epsilonrt/piphons/extras/hardware/gerber/piphons-shield - CADCAM Mechanical 1.TXT

G04 PROTEUS RS274X GERBER FILE*
%FSLAX24Y24*%
%MOIN*%
%ADD36C,0.0080*%
G54D36*
X-16732Y-11007D02*
X+16732Y-11007D01*
X+16732Y+11039D01*
X-16732Y+11039D01*
X-16732Y-11007D01*
M00*
