epsilonrt/piphons/examples/piphons-demo/README.md

# [libpiphons](https://github.com/epsilonrt/piphons) Full PiPhons example

This example shows how to manage a voice server.  
The program waits for a call, counts the number of rings and picks up
the phone after 3 rings.  
After a welcome message, the program waits for the other party to press
keys and diffuse a different message for each one.  
If the other party presses 2 # keys successively, the server says a
goodbye message and hangs up the phone.  

To build this program, you must type the command:

    $ g++ -o piphons-demo main.cpp $(pkg-config --cflags --libs libpiphons)
    
You can then execute the program :

    $ sudo ./piphons-demo

`sudo` is necessary for an access to the memory mapping of the GPIO. 
You can enable the **setuid** bit to avoid `sudo` in the future :

    $ sudo chmod u+s piphons-demo
    $ ./piphons-demo

With [Codelite](https://codelite.org/) it's easier and funny, right ? 

Debugging with Codelite

The `libpiphons-dev` package installs a project template in Codelite...
