epsilonrt/piphons/extras/hardware/piphons-shield-bom.ods

Category | Quantity | Reference | Value | Order Code | Package
Resistors | 1 | R1 | 10k |  | 2512
Resistors | 3 | R2,R6,R9 | 1k |  | 0805
Resistors | 1 | R3 | 22R |  | 1206
Resistors | 3 | R4,R5,R8 | 33k |  | 0805
Resistors | 6 | R7,R11,R12,R14,R15,R17 | 100k |  | 0805
Resistors | 1 | R10 | 300R |  | 0805
Resistors | 1 | R13 | 43k |  | 0805
Resistors | 1 | R16 | 300k |  | 0805
Resistors | 1 | R18 | 27k |  | 0805
Resistors | 1 | R19 | 1k2 |  | 0805
Resistors | 1 | R20 | 10k |  | 0805
Capacitors | 2 | C1,C9 | 100pF |  | 0805
Capacitors | 1 | C2 | 470n |  | 1812
Capacitors | 1 | C3 | 1u |  | 0805
Capacitors | 1 | C4 | 1nF |  | 0805
Capacitors | 1 | C5 | 10uF |  | 1206
Capacitors | 1 | C6 | 4.7uF |  | 0805
Capacitors | 8 | C7,C10-C13,C16,C18,C22 | 100nF |  | 0805
Capacitors | 1 | C8 | 22uF |  | 0805
Capacitors | 2 | C14,C15 | 22p |  | 0805
Capacitors | 3 | C17,C20,C23 | 1uF |  | 0805
Capacitors | 1 | C19 | 2.2uF |  | 0805
Capacitors | 1 | C21 | 33nF |  | 0805
Integrated Circuits | 1 | U1 | 4N35 |  | DIL06
Integrated Circuits | 1 | U2 | LH1540AT |  | DIL06
Integrated Circuits | 1 | U3 | LMV358M |  | SOIC127P600X175-8
Integrated Circuits | 1 | U4 | HT9170D |  | SOP18W
Integrated Circuits | 1 | U5 | LM567 |  | SO8
Transistors | 1 | Q1 | FZT600 |  | SOT223-3
Transistors | 1 | Q2 | MMBT3904 |  | SOT23-Q
Diodes | 1 | D1 | SMBJ160CA |  | DO214-AA
Diodes | 2 | D2,D3 | MMSZ5230BT1G |  | SOD123
Diodes | 1 | D4 | LED-RED |  | LEDC2012X120
Diodes | 2 | D5,D6 | MMSZ15T1G |  | SOD123
Diodes | 1 | D7 | SMBJ15CA |  | DO214-AA
Diodes | 1 | D8 | LED-GREEN |  | LEDC2012X120
Diodes | 1 | D9 | MB2S |  | SOIC4
Miscellaneous | 1 | FU1 | 500mA |  | 1812
Miscellaneous | 1 | J1 | RJ11-6P4C |  | RJ11-6P4C
Miscellaneous | 1 | J2 | CONN3-JACK |  | CONN-3-MX387GL
Miscellaneous | 1 | J3 | CONN-5 |  | CONN-5-HE14
Miscellaneous | 1 | P1 | CONN-2X13 |  | CONN-2X13-HE14
Miscellaneous | 14 | PT1-PT14 | TEST-POINT |  | TP-TAB37800868
Miscellaneous | 1 | TR1 | SM-LP-5001 |  | TR-SM-LP-5001
Miscellaneous | 1 | X1 | 3MHz579545 |  | XTAL18
