epsilonrt/piphons/extras/hardware/piphons-shield-pcb.pdf

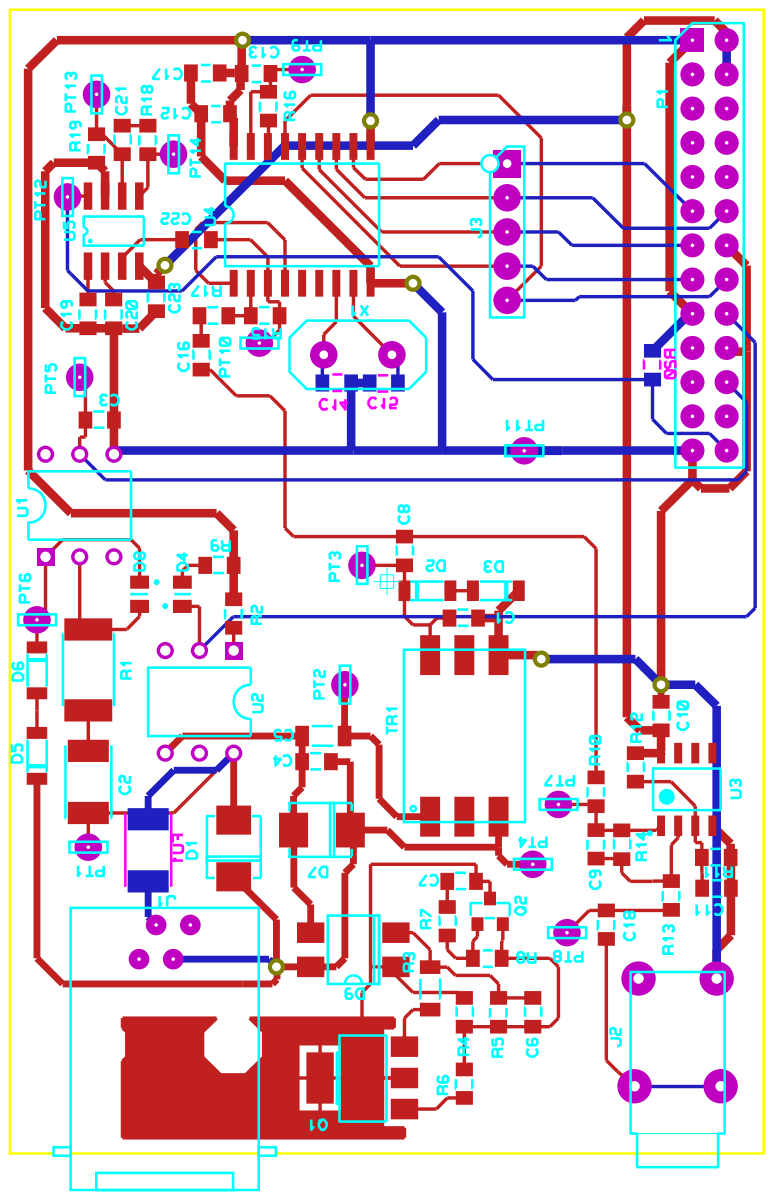
[picture p3: page 1]
