epsilonrt/piphons/extras/hardware/piphons-shield-sch.pdf

D4

PT2

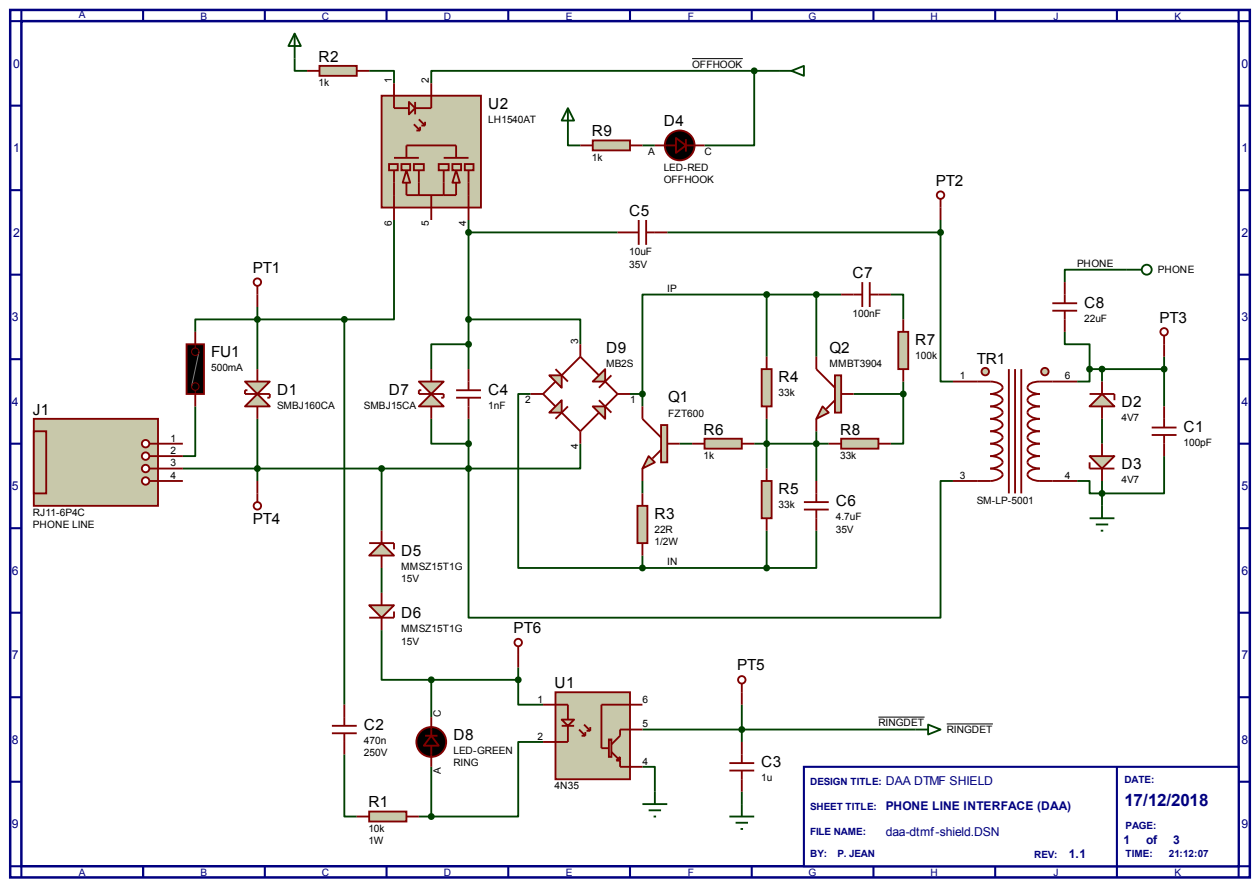
[picture p4: page 1]

DESIGN TITLE: DAA DTMF SHIELD

PHONE LINE INTERFACE (DAA)
daa-dtmf -shield.DSN

R10

R12

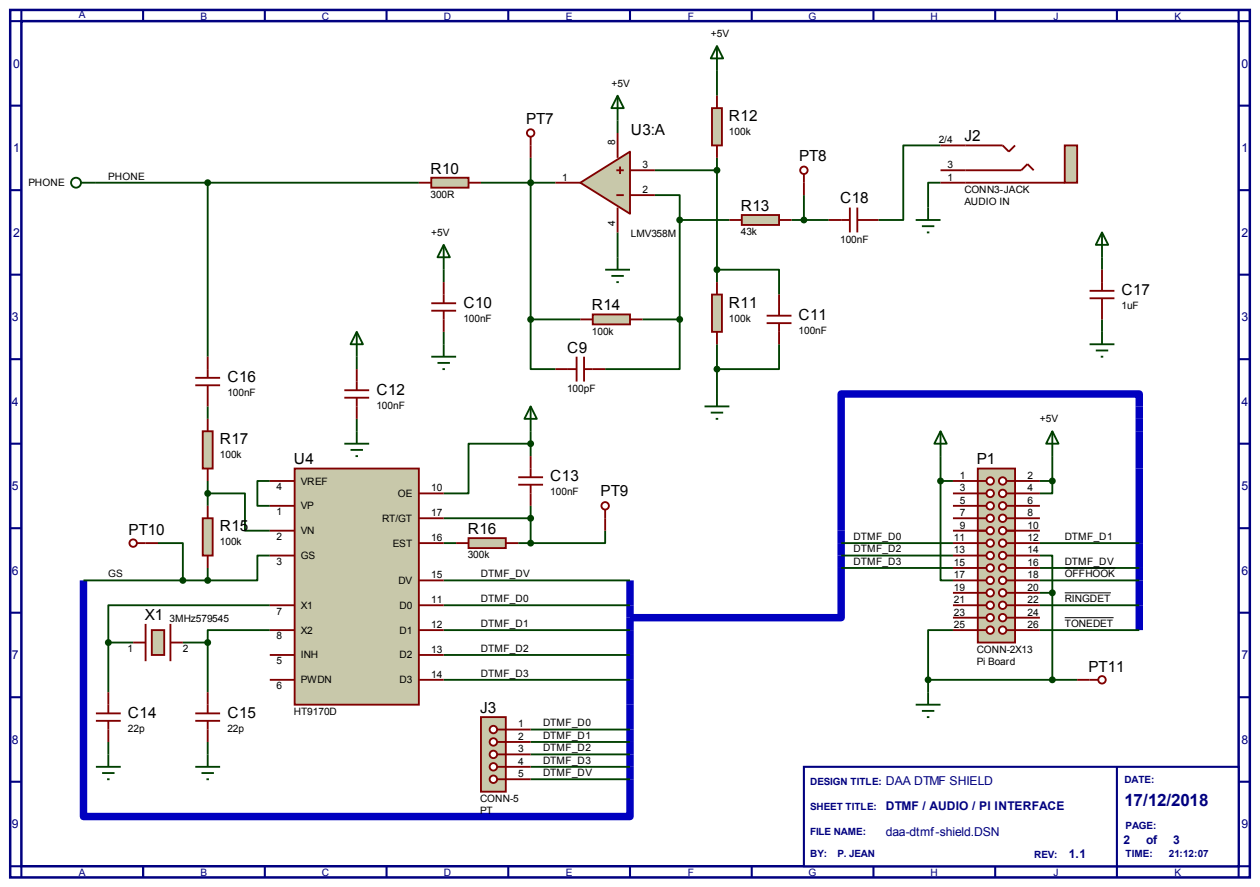
[picture p5: page 2]

DESIGN TITLE: DAA DTMF SHIELD

DTMF / AUDIO / PI INTERFACE
daa-dtmf -shield.DSN

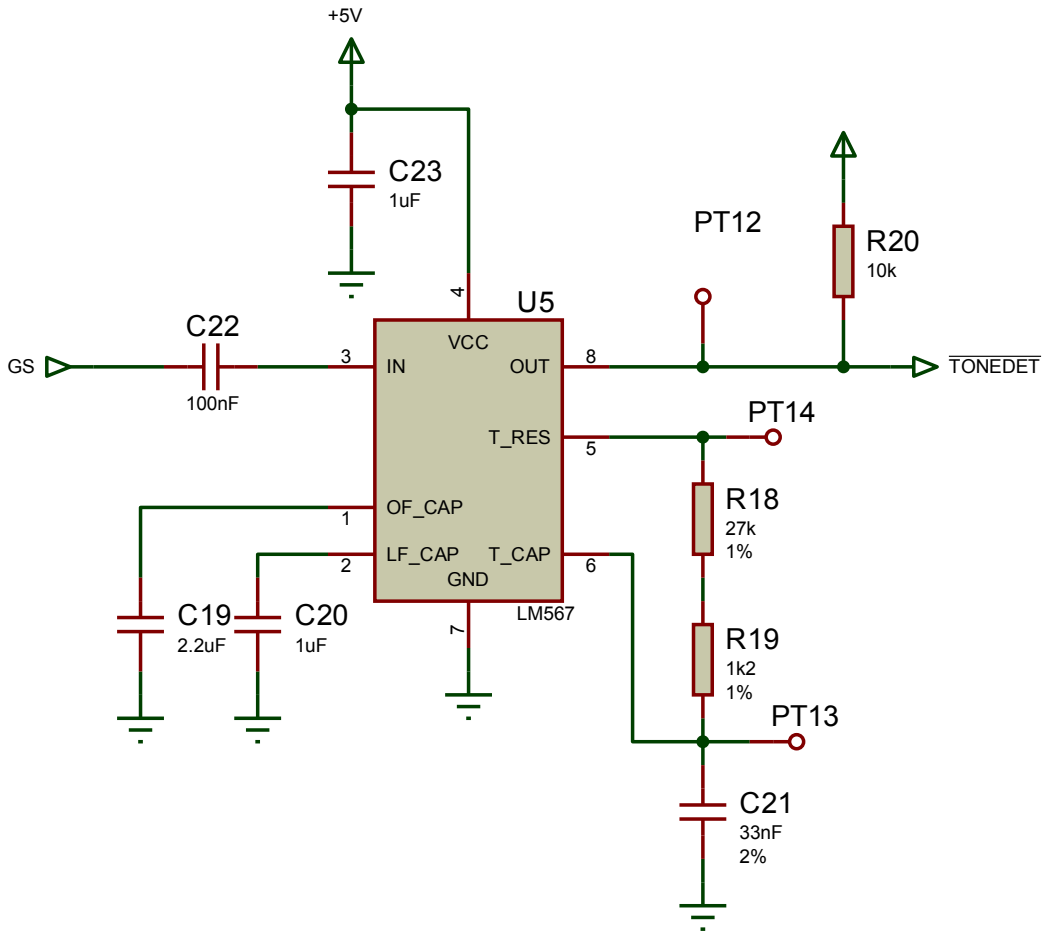
[picture p6: page 3]

DESIGN TITLE: DAA DTMF SHIELD

TONE DECODER
daa-dtmf -shield.DSN
