epsilonrt/piphons/(list of files, drawings)

Other design files:
extras/hardware/proteus/daa-offhook-sim.DSN
extras/hardware/proteus/piphons-shield.DSN
extras/hardware/proteus/piphons-shield.LYT
