epsilonrt/piphons/src/daa.cpp

/* Copyright © 2018-2019 Pascal JEAN, All rights reserved.
 * This file is part of the libpiphons Library.
 *
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
 * You should have received a copy of the GNU Lesser General Public License
 * along with the libpiphons Library; if not, see <http://www.gnu.org/licenses/>.
 */
#include "daa_p.h"
#include <piduino/clock.h>

namespace Piphons {

  // ---------------------------------------------------------------------------
  //
  //                          Daa::Private Class
  //
  // ---------------------------------------------------------------------------

  // ---------------------------------------------------------------------------
  Daa::Private::Private (Daa * q, int rp, int ohp, bool rel, bool ohel) :
    q_ptr (q),
    ringPin (gpio.pin (rp)),
    offhookPin (gpio.pin (ohp)) ,
    tonePin (0),
    ringEnabledLevel (rel),
    offhookEnabledLevel (ohel),
    ringingBeforeOffhook (8),
    ringingSinceHangup (0),
    toneHangupEnable (false),
    tonePwMin (0),
    tonePwMax (0),
    tonePulseCount (0),
    lastTone (0),
    tonePulseBeforeHanghup (0),
    userRingingHandler (0),
    userOffhookHandler (0),
    userHangupToneHandler (0),
    lastRinging (0),
    hookFlash (false),
    isOpen (false) {}

  // ---------------------------------------------------------------------------
  Daa::Private::Private (Daa * q, int rp, int ohp, int tp) :
    Private (q, rp, ohp, false, false)  {

    if (tp >= 0) {

      tonePin = &gpio.pin (tp);
    }
  }

  // ---------------------------------------------------------------------------
  Daa::Private::Private (const Daa::Private & other) :
    q_ptr (other.q_ptr),
    ringPin (other.ringPin),
    offhookPin (other.offhookPin) ,
    tonePin (other.tonePin),
    ringEnabledLevel (other.ringEnabledLevel),
    offhookEnabledLevel (other.offhookEnabledLevel),
    toneHangupEnable (other.toneHangupEnable),
    tonePwMin (other.tonePwMin),
    tonePwMax (other.tonePwMax),
    tonePulseBeforeHanghup (other.tonePulseBeforeHanghup) {

    // requires exclusive ownership to write to *this
    std::unique_lock<std::shared_timed_mutex> lhs (mut, std::defer_lock);
    // requires shared ownership to read from other
    std::shared_lock<std::shared_timed_mutex> rhs (other.mut, std::defer_lock);
    std::lock (lhs, rhs);

    // assign data
    ringingBeforeOffhook = other.ringingBeforeOffhook;
    ringingSinceHangup = other.ringingSinceHangup;
    userRingingHandler = other.userRingingHandler;
    userOffhookHandler = other.userOffhookHandler;
    userHangupToneHandler = other.userHangupToneHandler;
    lastRinging = other.lastRinging;
    tonePulseCount = other.tonePulseCount;
    lastTone = other.lastTone;
    hookFlash = other.hookFlash;
    isOpen = other.isOpen;
  }

  // ---------------------------------------------------------------------------
  Daa::Private::~Private() = default;

  // ---------------------------------------------------------------------------
  bool Daa::Private::open() {

    if (gpio.open()) {

      offhookPin.setMode (Pin::ModeOutput);
      offhook (false);

      ringPin.setMode (Pin::ModeInput);
      ringPin.setPull (ringEnabledLevel ? Pin::PullDown : Pin::PullUp);
      ringPin.attachInterrupt (Private::ringIsr, ringEnabledLevel ? Pin::EdgeRising : Pin::EdgeFalling, this);
      if (tonePin) {

        tonePin->setMode (Pin::ModeInput);
        tonePin->setPull (Pin::PullOff);
        tonePin->attachInterrupt (Private::toneIsr, Pin::EdgeBoth, this);
      }
      isOpen = true;
    }
    return isOpen;
  }

  // ---------------------------------------------------------------------------
  void Daa::Private::close() {

    ringPin.detachInterrupt();
    if (tonePin) {

      tonePin->detachInterrupt();
    }
    isOpen = false;
  }

  // ---------------------------------------------------------------------------
  void Daa::Private::ringIsr (void * data) {
    Private * d;
    bool hookFlash;
    int ringingSinceHangup;
    int ringingBeforeOffhook;
    DaaHandler userRingingHandler;
    DaaHandler userOffhookHandler;
    bool offhookQuickly;
    unsigned long now;
    unsigned long dt;

    now = clk.millis();
    d = reinterpret_cast<Daa::Private *> (data);
    dt = now - d->lastRinging;
    d->lastRinging = now;
    ringingSinceHangup = d->ringingSinceHangup;
    offhookQuickly = false;

    {
      // requires shared ownership to read from other this data
      std::shared_lock<std::shared_timed_mutex> lk (d->mut);
      hookFlash = d->hookFlash;
      ringingBeforeOffhook = d->ringingBeforeOffhook;
      userRingingHandler = d->userRingingHandler;
      userOffhookHandler = d->userOffhookHandler;
    }

    if ( (ringingSinceHangup > 0) && (dt > 7000)) {

      if ( (hookFlash) && (ringingSinceHangup <= 3) && (dt <= 60000)) {

        offhookQuickly = true;
      }
      else {

        ringingSinceHangup = 0;
      }
    }
    ringingSinceHangup++;
    d->ringPin.read();  // phony reading, to erase irq !

    {
      // requires exclusive ownership to write to ringingSinceHangup
      std::lock_guard<std::shared_timed_mutex> lk (d->mut);
      d->ringingSinceHangup = ringingSinceHangup;
    }

    if (userRingingHandler) {

      userRingingHandler (d->q_ptr);
    }

    if (!d->isOffhook()) {

      if ( (ringingSinceHangup >= ringingBeforeOffhook) || offhookQuickly) {

        d->offhook (true);
        if (userOffhookHandler) {

          userOffhookHandler (d->q_ptr);
        }
      }
    }
    else {

      d->offhook (false);
    }
  }

  // ---------------------------------------------------------------------------
  void Daa::Private::toneIsr (void * data) {
    Private * d;
    int tonePulseCount, tonePulseBeforeHanghup;
    DaaHandler userHangupToneHandler;
    unsigned long now, dt, tonePwMin, tonePwMax;
    bool toneHangupEnable;

    now = clk.millis();
    d = reinterpret_cast<Daa::Private *> (data);

    {
      // requires shared ownership to read from other this data
      std::shared_lock<std::shared_timed_mutex> lk (d->mut);
      toneHangupEnable = d->toneHangupEnable;
      tonePwMin = d->tonePwMin;
      tonePwMax = d->tonePwMax;
      tonePulseCount = d->tonePulseCount;
      tonePulseBeforeHanghup = d->tonePulseBeforeHanghup;
      userHangupToneHandler = d->userHangupToneHandler;
    }

    if (toneHangupEnable) {

      if (d->lastTone == 0) {
        // first edge
        d->lastTone = now;

      }
      else {

        dt = now - d->lastTone;
        d->lastTone = now;

        if ( (dt >= tonePwMin) && (dt <= tonePwMax)) {

          tonePulseCount++;
          {
            // requires exclusive ownership to write to tonePulseCount
            std::lock_guard<std::shared_timed_mutex> lk (d->mut);
            d->tonePulseCount = tonePulseCount;
          }

          if (tonePulseCount >= tonePulseBeforeHanghup) {

            d->offhook (false);
            if (userHangupToneHandler) {

              userHangupToneHandler (d->q_ptr);
            }
            tonePulseCount = 0;
            d->lastTone = 0;
          }
        }
        else {

          // first edge
          d->lastTone = now;
        }

        {
          // requires exclusive ownership to write to tonePulseCount
          std::lock_guard<std::shared_timed_mutex> lk (d->mut);
          d->tonePulseCount = tonePulseCount;
        }
      }
      d->tonePin->read();  // phony reading, to erase irq !
    }
  }

  // ---------------------------------------------------------------------------
  void Daa::Private::offhook (bool value) {

    offhookPin.write (value == offhookEnabledLevel);
  }

  // ---------------------------------------------------------------------------
  bool Daa::Private::isOffhook () const {

    return offhookPin.read () == offhookEnabledLevel;
  }

  // ---------------------------------------------------------------------------
  //
  //                             Daa Class
  //
  // ---------------------------------------------------------------------------

  // ---------------------------------------------------------------------------
  Daa::Daa (Daa::Private &dd) : d_ptr (&dd) {}

  // ---------------------------------------------------------------------------
  Daa::Daa (int rp, int ohp, bool rel, bool ohel) :
    d_ptr (new Private (this, rp, ohp, rel, ohel)) {}

  // ---------------------------------------------------------------------------
  Daa::Daa (int rp, int ohp, int tp) :
    d_ptr (new Private (this, rp, ohp, tp)) {}

  // ---------------------------------------------------------------------------
  Daa::Daa (const Daa & other) :
    d_ptr (new Private (*other.d_ptr)) {}

  // ---------------------------------------------------------------------------
  void Daa::swap (Daa &other) {

    d_ptr.swap (other.d_ptr);
  }

// ---------------------------------------------------------------------------
  Daa& Daa::operator= (const Daa &other) {

    Daa (other).swap (*this);
    return *this;
  }

  // ---------------------------------------------------------------------------
  Daa::~Daa() {

    close();
  }

  // ---------------------------------------------------------------------------
  bool Daa::open() {

    if (!isOpen()) {
      PIMP_D (Daa);

      return d->open();
    }
    return true;
  }

  // ---------------------------------------------------------------------------
  void Daa::close() {

    if (isOpen()) {
      PIMP_D (Daa);

      offhook (false);
      d->close();
    }
  }

  // ---------------------------------------------------------------------------
  bool Daa::isOpen() const {
    PIMP_D (const Daa);

    return d->isOpen;
  }

  // ---------------------------------------------------------------------------
  void Daa::setRingingHandler (DaaHandler handler) {
    PIMP_D (Daa);

    std::lock_guard<std::shared_timed_mutex> lk (d->mut);
    d->userRingingHandler = handler;
  }

  // ---------------------------------------------------------------------------
  void Daa::setOffhookHandler (DaaHandler handler) {
    PIMP_D (Daa);

    std::lock_guard<std::shared_timed_mutex> lk (d->mut);
    d->userOffhookHandler = handler;
  }

  // ---------------------------------------------------------------------------
  void Daa::setHangupToneHandler (DaaHandler handler) {
    PIMP_D (Daa);

    std::lock_guard<std::shared_timed_mutex> lk (d->mut);
    d->userHangupToneHandler = handler;
  }

  // ---------------------------------------------------------------------------
  bool Daa::setHangupToneDetect (bool enable,  int tonePulseBeforeHanghup, unsigned long pwMin, unsigned long pwMax) {
    PIMP_D (Daa);

    if (d->tonePin) {
      std::lock_guard<std::shared_timed_mutex> lk (d->mut);
      d->toneHangupEnable = enable;
      d->tonePwMin = pwMin;
      d->tonePwMax = pwMax;
      d->tonePulseBeforeHanghup = tonePulseBeforeHanghup;
      d->tonePulseCount = 0;
      return true;
    }
    return false;
  }

  // ---------------------------------------------------------------------------
  void Daa::offhook (bool value) {
    PIMP_D (Daa);

    if (isOpen()) {

      d->offhook (value);
    }
    if (value == false) {

      d->ringingSinceHangup = 0;
    }
  }

  // ---------------------------------------------------------------------------
  bool Daa::isOffhook() const {

    if (isOpen()) {
      PIMP_D (const Daa);

      return d->isOffhook();
    }
    return false;
  }

  // ---------------------------------------------------------------------------
  void Daa::setRingingBeforeOffhook (int count) {
    PIMP_D (Daa);

    std::lock_guard<std::shared_timed_mutex> lk (d->mut);
    d->ringingBeforeOffhook = count;
  }

  // ---------------------------------------------------------------------------
  int Daa::ringingBeforeOffhook() const {
    PIMP_D (const Daa);

    return d->ringingBeforeOffhook;
  }

  // ---------------------------------------------------------------------------
  int Daa::ringingSinceHangup() const {
    PIMP_D (const Daa);

    std::shared_lock<std::shared_timed_mutex> lk (d->mut);
    return d->ringingSinceHangup;
  }

  // ---------------------------------------------------------------------------
  void Daa::setHookFlash (bool value) {
    PIMP_D (Daa);

    std::lock_guard<std::shared_timed_mutex> lk (d->mut);
    d->hookFlash = value;
  }

  // ---------------------------------------------------------------------------
  bool Daa::hookFlash() const {
    PIMP_D (const Daa);

    return d->ringingSinceHangup;
  }

}
/* ========================================================================== */
