epsilonrt/piphons/src/tts.cpp

/* Copyright © 2018-2019 Pascal JEAN, All rights reserved.
 * This file is part of the libpiphons Library.
 *
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
 * You should have received a copy of the GNU Lesser General Public License
 * along with the libpiphons Library; if not, see <http://www.gnu.org/licenses/>.
 */
#include <exception>
#include <piduino/system.h>
#include <piduino/clock.h>
#include "tts_p.h"

namespace Piphons {

  // ---------------------------------------------------------------------------
  //
  //                            Tts::Private Class
  //
  // ---------------------------------------------------------------------------

  // ---------------------------------------------------------------------------
  Tts::Private::Private (Tts * q) :
    q_ptr (q) {

  }

  // ---------------------------------------------------------------------------
  Tts::Private::~Private() = default;

  // ---------------------------------------------------------------------------
  void * Tts::Private::parser (const std::string & voiceIso, const std::string & device,
                               std::future<void> run, Private * d) {
    std::string text;
    bool success = d->engine.open (voiceIso, device);

    while (d->engine.isOpen() && success) {

#if PIPHONS_SUN8I_CODEC_ANALOG_BUGFIX
      // sun8i-codec-analog bug fixes
      // this driver bug removes the first 700 milliseconds of sound.
      static unsigned long tprev = 0;
      unsigned long t;

      t = Piduino::clk.millis();

      if ( (tprev == 0) || ( (t - tprev) > 2000)) {

        tprev = t;
        success = d->engine.write ("");
        if (success) {

          success = d->engine.play();
          if (success) {
            Piduino::clk.delay (700);
          }
        }
      }
#endif // PIPHONS_SUN8I_CODEC_ANALOG_BUGFIX

      if (success && d->fifo.read (text, 100)) {

        success = d->engine.write (text);
        if (success) {

          success = d->engine.play();
        }
      }
      else {

        if (run.wait_for (std::chrono::milliseconds (100)) != std::future_status::timeout) {

          break;
        }
      }
    }
    d->engine.close();
    return 0;
  }

  // ---------------------------------------------------------------------------
  //
  //                                Tts Class
  //
  // ---------------------------------------------------------------------------

  // ---------------------------------------------------------------------------
  Tts::Tts (Private &dd) : d_ptr (&dd) {}

  // ---------------------------------------------------------------------------
  Tts::Tts () : d_ptr (new Private (this)) {}

  // ---------------------------------------------------------------------------
  Tts::~Tts() = default;

  // ---------------------------------------------------------------------------
  bool Tts::open (const std::string & voiceIso, const std::string & device) {

    if (!isOpen()) {
      PIMP_D (Tts);

      // Fetch std::future object associated with promise
      std::future<void> running = d->stopParsing.get_future();

      // Starting Thread & move the future object in lambda function by reference
      d->parseThread = std::thread (&Private::parser, voiceIso, device, std::move (running), d);
    }
    return isOpen();
  }

  // ---------------------------------------------------------------------------
  void Tts::close() {

    if (isOpen()) {
      PIMP_D (Tts);

      // Set the value in promise
      d->stopParsing.set_value();
      // Wait for thread to join
      d->parseThread.join();
    }
  }

  // ---------------------------------------------------------------------------
  bool Tts::isOpen() const {
    PIMP_D (const Tts);

    return d->parseThread.joinable();
  }

  // ---------------------------------------------------------------------------
  void Tts::write (const std::string & text, int volume, int speed, int pitch) {
    PIMP_D (Tts);

    d->text = Engine::formatText (text, volume, speed, pitch);
  }

  // ---------------------------------------------------------------------------
  void Tts::append (const std::string & text, int volume, int speed, int pitch) {
    PIMP_D (Tts);

    d->text += Engine::formatText (text, volume, speed, pitch);
  }

  // ---------------------------------------------------------------------------
  bool Tts::say () {
    PIMP_D (Tts);

    if (isOpen()) {

      d->fifo.write (d->text);
      return true;
    }
    return false;
  }

  // ---------------------------------------------------------------------------
  bool Tts::say (const std::string & text, int volume, int speed, int pitch) {

    write (text, volume, speed, pitch);
    return say();
  }

  // ---------------------------------------------------------------------------
  const Tts::Voice & Tts::voice() const {
    PIMP_D (const Tts);

    return d->engine.voice();
  }

  // ---------------------------------------------------------------------------
  const std::string & Tts::errorString() const {
    PIMP_D (const Tts);

    return d->engine.errorString();
  }

  // ---------------------------------------------------------------------------
  const std::string & Tts::device() const {
    PIMP_D (const Tts);

    return d->engine.device();
  }
}
/* ========================================================================== */
