epsilonrt/piphons/src/tts_player.cpp

/* Copyright © 2018-2019 Pascal JEAN, All rights reserved.
 * This file is part of the libpiphons Library.
 *
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
 * You should have received a copy of the GNU Lesser General Public License
 * along with the libpiphons Library; if not, see <http://www.gnu.org/licenses/>.
 */
#include <exception>
#include <piduino/system.h>
#include "tts_player_p.h"

namespace Piphons {

  // ---------------------------------------------------------------------------
  //
  //                      Tts::Player::Private Class
  //
  // ---------------------------------------------------------------------------

  // ---------------------------------------------------------------------------
  Tts::Player::Private::Private (Tts::Player * q) :
    q_ptr (q),
    handle (0),
    mode (0) { }

  // ---------------------------------------------------------------------------
  Tts::Player::Private::~Private() = default;

  // ---------------------------------------------------------------------------
  //
  //                        Tts::Player Class
  //
  // ---------------------------------------------------------------------------

  // ---------------------------------------------------------------------------
  Tts::Player::Player (Tts::Player::Private &dd) : d_ptr (&dd) {}

  // ---------------------------------------------------------------------------
  Tts::Player::Player (const std::string & dev) :
    d_ptr (new Private (this)) {
      
    setDevice (dev);
  }

  // ---------------------------------------------------------------------------
  Tts::Player::~Player() {

    close();
  }

  // ---------------------------------------------------------------------------
  const std::string & Tts::Player::errorString() const {
    PIMP_D (const Tts::Player);

    return d->error;
  }

  // ---------------------------------------------------------------------------
  void Tts::Player::setDevice (const std::string & dev) {
    PIMP_D (Tts::Player);

    d->device = dev;
  }

  // ---------------------------------------------------------------------------
  const std::string & Tts::Player::device() const {
    PIMP_D (const Tts::Player);

    return d->device;
  }

  // ---------------------------------------------------------------------------
  bool Tts::Player::open () {

    if (!isOpen()) {
      PIMP_D (Tts::Player);
      int err;

      if ( (err = snd_pcm_open (&d->handle, d->device.c_str(), SND_PCM_STREAM_PLAYBACK, d->mode)) < 0) {

        d->error = snd_strerror (err);
      }

      else if ( (err = snd_pcm_set_params (d->handle,
                                           SND_PCM_FORMAT_S16_LE,
                                           SND_PCM_ACCESS_RW_INTERLEAVED,
                                           1,
                                           16000,
                                           1,
                                           500000)) < 0) { // 0.5 sec
        d->error = snd_strerror (err);
        close();
      }
    }
    return isOpen();
  }

  // ---------------------------------------------------------------------------
  void Tts::Player::close() {

    if (isOpen()) {
      PIMP_D (Tts::Player);

      snd_pcm_close (d->handle);
      d->handle = 0;
    }
  }

  // ---------------------------------------------------------------------------
  bool Tts::Player::isOpen() const {
    PIMP_D (const Tts::Player);

    return d->handle != 0;
  }

  // ---------------------------------------------------------------------------
  bool Tts::Player::write (const void * buffer, unsigned long size) {
    bool success = isOpen();

    if (success) {
      PIMP_D (Tts::Player);

      snd_pcm_sframes_t frames = snd_pcm_writei (d->handle, buffer, size / 2);
      success = (frames >= 0);

      if (! success) {

        frames = snd_pcm_recover (d->handle, frames, 0);
        success = (frames >= 0);
        if (! success) {
          d->error = snd_strerror (frames);
        }
      }
    }
    return success;
  }
}
/* ========================================================================== */
