epsilonrt/piphons/(commit log)

2018-12-17 Adds LM567 Tone decoder
    [daa-dtmf-shield.DSN, daa-dtmf-shield.LYT]
2018-12-17 Update hardware doc
    [daa-dtmf-shield-bom.ods, daa-dtmf-shield.DSN]
2018-12-21 Rename project piphons for Pi Phone Server
    [piphons-shield-bom.ods, piphons-shield.DSN, piphons-shield.LYT]
2019-01-05 Fixes the sun8i-codec-analog driver bug
    [tts.cpp]
2019-01-17 Update hardware schematic
    [daa-offhook-sim.DSN, piphons-shield.DSN]
2019-01-18 Update PCB
    [piphons-shield.LYT]
